bekatresh/ECE-445/notebooks/Eshrit_notebook/New_entries.Md

# Date: January 29

Our group finalised the project idea over the week and we began to work on the project proposal. The main agenda was to come up with a comprehensive block diagram.
We identified three main subsystems: RFID, Breathalyzer, and Data management. We shared multiple ideas to discuss feasibility, and evaluate pros and cons.
We all brought our different ideas, potential pairs of problems an solutions to the table and collaborated effectively to ensure each subsystem complemented the others and functioned well in the overall system. We made sure everyone understood their responsibilities and their duties towards each other. By the end we had a skeleton and a somewhat finished block diagram. Provided below is an image for our vision for the project.



# Date: February 1

We delved further into the problem and tried to identify more issues and ideas on how to tackle those issues. Essentially we thought more about expanding on the implementation of our subsystems and laid out an initial gameplan including the parts we would need and how the product we are delivering would actually be used in practice. We discussed the project idea on a more user friendly level. The project would include RFID-enabled wristbands/cards, a breathalyzer, a Raspberry Pi, and a microcontroller to measure the blood alcohol content (BAC) levels of users and encourage more responsible drinking.
Essentially TipsyTracker would remind users to get their BAC levels checked so they can be in control of their senses on a real scale analysis. The system would alert the host if a guest's BAC levels are above a certain threshold.
I carried forth discussions about the real time use cases and issues about device liquid safety and anticipating the problems for the device in real time such as what would we have the device do in case of system failure, and what would could cause our project to either malfunction or provide mismanaged data. Privacy is also a concern that we would have to tackle since we would be handling so much data about BAC levels.

# Date: February 3

We finalised the proposal and made small edits to it in accordance with the formatting of previous semesters. I assisted with finishing up the block diagram and making the high level requirements be more suitable to the overall success of our project instead of depending on the subsystem workings. We made plans of getting final inputs from the TA and making a submission for the project proposal a day before the deadline.

# Date: February 6th

I picked up the the RFID component and soldered it so that for our team meeting the following day, we can breadboard all components together and test them to see if they work before we proceed with the manafacturing process. Below is a picture of the component we used.



# Date: February 7

We had made plans to breadboard the ordered components and were able to successfully breadboard the complete system design. This step was imperative to test the functionality of the various subsystems and identify any potential issues that needed to be resolved before proceeding with the manufacturing process. Akash made the decision to take the lead on making the PCB schematics with the incorporated parts.

Additionally, breadboarding the entire system helped the team to verify that all the components were correctly interconnected and that the system was working according to the expected standards. By utilizing the expertise of each team member, any problems encountered during testing were effectively addressed to ensure that the system operated as intended.

# Date: February 20

We decided to work on the design document and laid out a plan on how we would use the proposal as a basis and expand on the requirements and verification of the subsystems. In the course of the discussion, we carefully reviewed the current system design, identified areas that required clarification or more development, and discussed the implementation plan. Moreover, we identified potential issues that could arise during the manufacturing process. This comprehensive review allowed us to identify areas for improvement and confirm that the system design was well-documented and comprehended by all team members. This served as a valuable checkpoint regarding lower level understanding of the project. Akash also went over the updates of the PCB schematic. Sumedh, Akash and I at the end of the meeting came up with a more comprehensive division of labor which would be laid out in the schedule subsection of the design document.

# Date: February 21

Hashed out the final editings of the design document, I planned out the schedule and wrote it in the format that was suitable for submission along the lines with what my teammates and I went over in the previous meeting. Followed the plan of expanding the requirements and verification of the subsystems and finished that while concluding the brainstorming from the previous meeting on what verifications would conduct thorough checks for the workings of our subsystems. Prepared the design document for final submission and decided to submit it a day before the deadline.

# Date: February 27

Conducted a successful design review presentation where my teammates and I went over our design document with the Professors and some TAs. We got valuable feedback about a possible problem where our device could be provided with fake BAC values for a user when the air that they blow into the breathalyzer is not generated with enough pressure so that it comes from the lungs. To tackle this the Professor suggested the addition of a pressure sensor and we decided to go over the feasibility of this addition with the TA.

# Date: March 1

I picked up the the pressure sensor component and soldered it so that for our next team meeting, we can breadboard it and test to see if it works as expected before we proceed with the manafacturing process. Below is a picture of the pressure sensor we would be expermenting with.



# Date: March 6

Went over the setup of the website where users can register their information and how their BAC contents get updated with the latest measurements. Went over the functionality of the user getting a notification to test, testing within intervals setup by us and a  text broadcast in case of a subsystem failure which would indicate that the device is not working currently. This helped us discuss more ideas and features in case of subsystem failures. We also discussed the plan for soldering given the PCB. 

# Date: March 7

Headed over to the ECE lab to try and solder the first PCB since we needed to discuss the feasibility of soldering given some of the components were too small (0402 resistors, the diodes and capacitors). The soldering irons in the general area had tips that were too wide but in the special area with the finer soldering tips and the hot air I was able to solder the smaller components much more easily although it was still difficult. We then discussed problems even if I was able to get the components on. We could foresee some bridging issues due to the PCB having components that were too close and the components not having enough solder. We then moved to a newer PCB design which would incorporate through hole components. Below is are the images of the PCB and the PCB with some components soldered.

PCB_1

PCB_1_sol

# Date: March 14

We held a discussion with our TA and went over the feasibility of including the earlier discussed pressure sensor into our project. This was an idea we came back to as mentioned earlier so that the breath tests actually detect air from the lungs for BAC level checks rather than a user who can essentially cheat the breath test. We also briefly went over the design document and any other issues surrounding tipsy tracker and or how we can improve tipsy tracker. This is actually what brought back up the incorporation of a pressure sensor. The TA was for the inclusion of the pressure sensor and after the meeting Akash, Sumedh and I began our research regarding the pressure sensor that I had soldered earlier and how it would fit in with the other subsystems. 

# Date: March 20

Today we conducted the first of the two events that we planned to help with getting accurate BAC level measurements from the Tipsy Tracker device. We invited ten of our friends and made sure that they understood the purpose of the event. Our main objective was to gather accurate and consistent data while creating a relaxed and enjoyable atmosphere for our guests. To achieve this, we offered various snacks and beverages, games and activities to keep the participants engaged. Throughout the gathering, we emphasized the significance of the data collection process for the success of our project, stressing the role each person played in it.
During the event, our guests consumed alcohol and blew into our Arduino-based sensor and commercial breathalyzer at regular intervals. We carefully documented the readings from both devices, along with any contextual factors that could have influenced the results, such as the type and quantity of alcohol consumed and the duration between drinks. This enabled us to obtain valuable data to refine our device and algorithms and gain insights into the real-world conditions under which our device would be used. Below is the truncated image of our training data.



# Date: March 21

Today was when we revisited the idea of incorporating the pressure sensor in our project. To start our discussion, we conducted an extensive literature review on pressure sensors and their practical applications. This process helped us comprehend the underlying principles and technologies that govern the functioning of these sensors, which in turn, gave us the confidence to tackle potential issues that may arise.
In a meeting, we discussed several ideas, such as placing a cloth in front of the breathalyzer, creating an enclosure to detect differences in pressure, and covering the pressure sensor with paper to observe changes. We debated the pros and cons of each idea and took into account factors such as cost, implementation ease, and potential impact on the overall device performance.
However each method was not feasible to warrant inclusion of a pressure sensor

Reasons of failure:
1) Cloth failure: Provided inconsistent results which made differentiating changes in blowing pressure.
2) Enclosure to differentiate measurement of pressure: Sensor was not sensitive enough
3) Place a paper over the pressure sensor: Paper was not stable enough during a blow into the breathalyzer.

As a result we decided to move forward with the project without the inclusion of a pressure sensor.

# Date: March 22

Today we conducted the second of the two events that we plannedto help with getting accurate BAC level measurements from the Tipsy Tracker device. We would now be assessing the precision and accuracy of our calibrated system by comparing BAC level approximations with the BAC level readings from the commercial breathalyzer.
We again invited ten of our friends and conducted a series of tests during which each participant tested their BAC levels using Tipsy Tracker's breathalyzer and the commercial breathalyzer throughout the course of the event. Using this data we compounded it with the data gathered from the first event and looked for any obvious patterns or some sort of linear relationship between the two sensors and the two events. We then tried to figure out how we can map the arduino values to the model values keeping into account what the True BAC levels observed from the commerical breathalyzer showed. Below is the truncated image of our model data and how dissimilar it is from the true data.



# Date: March 23

Our team held a meeting and I picked up the newer version of the PCB which incorporated more spread out components and converted the surface mount components to through hole components. We also separated the components into different bags taking into account the values of resistors and capacitors to make the task of looking for components easier whilst soldering the PCB. I also printed out the schematic on paper so that while soldering I could cross-check this labeling. Below is an image of the physical board


# Date: March 24

Today we headed to the lab to knock off the soldering off some components. We were able to get the microcontroller soldered using the low temp solder and hot air. Once the microcontroller stabilized we added some more soldered using the fine tip soldering iron on each connection and it was verified by a TA as correct. 



# Date: March 25

We soldered 90% of the board adding the other components to the PCB and the sensors. Some surface mount components and a couple other components remained to be soldered. The USB to UART component used to program the microcontroller was almost impossible to solder. The replacement component could not be incorporated into our schematic. The image below shows a failed soldering attempt at U2.



# Date: March 28

We held a brief team discussion about the feasibility of soldering and just the project in general with our TA Dushyant. During our meeting, we shared valuable tips and tricks, and brainstormed potential solutions to enhance our soldering process. Some of the suggestions included investing in high-quality soldering equipment like a soldering station with temperature control and a hot air rework station for surface-mount components. We also considered attending workshops or classes to further develop our soldering skills.

# Date: April 4

We collectively decided that creating an alternate PCB utilizing the development board would be an important step. This would provide us with a reliable backup plan in case any unexpected issues arise with our primary breathalyzer system, thereby ensuring the overall success and dependability of our project. This decision was made to minimize any risks associated with potential problems in our main breathalyzer system. Below is the image for the layout of the Development board PCB.



# Date: April 8

Today arrived the development board PCB, which was created as a backup solution for our primary breathalyzer system. We will solder the component shortly.



# Date: April 10

We successfully finished soldering the Development board PCB. This was much easier than the other PCB designs as visible in the layout of the PCB above. Given the infeasibility of the USB to UART component in our design, it was looking like we would have to activate our backup option which was this PCB.
After soldering, we conducted rigorous testing to ensure that the PCB was functioning as intended, and we were pleased to find that it was successful. We also began discussing the possibility of creating a 3D enclosure to house the development board PCB. Below is an image of our soldered development board PCB.



# Date: April 15

With our Mock Demo coming up, our team held a meeting to prepare for it. We were advised by our TA to have the mock demo be as similar to the real demo as possible and we took this advice fairly seriously. We prepared a skit according to how it would be best to deliver our product to an audience guiding them through various test cases and enacting real life use cases. By conducting a practice session, we were able to refine our presentation skills, ensuring a smooth delivery of information and identifying any areas that needed improvement prior to the actual demonstration. During the rehearsal, each team member took turns presenting their respective portions of the TipsyTracker project, with a focus on clearly and concisely conveying the system's key attributes and advantages while also addressing potential inquiries or concerns.

# Date: April 18

The Mock demo helped us highlight very severe problems with our system. Our device is dependent on the party host setting up a hotspot connection to the device. This was not possible because the ECEB building has extremely poor cellular reception. This caused delay or the stoppage of the partygoers getting notifications about their BAC levels. The RFID subsystem also stopped working as expected, it was working erratically and then completely stopped working. We re-ordered the RFID sensor and resoldered the system.

# Date: April 22

Akash had briefed us on how to use the microcontroller's LAN to connect the modules to each other. However, we still had to show that the partygoers receiving notifications. Hence our team gathered to create a comprehensive video demonstrating all the notification features of our breathalyzer system. The primary objective was to showcase the complete functionality of our communication system, including sending notifications to users and hosts. This video would be presented during the demo to provide the audience with a clear understanding of how the communication system operates.

To ensure everything worked as intended, we set up the breathalyzer system and connected all the necessary components during the meeting. Each team member played a role in the filming process, from operating the breathalyzer system to recording the notifications on various devices.

We then recorded the functionality of our project highlighting the test cases of getting the notifications, the device being down, BAC levels being too high for the partygoers and other such cases which we felt were crucial to display the usefulness of TipsyTracker. Although, the ECEB had no cellular reception as a team, we were able to get around this problem and of course with advice from the TA verifying our new approach, were able to get back on track.

# Date: April 26

Today we conducted our final demo showcasing the functionality of our project. The demo went off without a hitch, with all subsystems working together in perfect harmony. Each team member confidently presented their component and stuck to the script well, emphasizing the unique features and benefits of the TipsyTracker.

# Date: April 27

We held a team meeting today to prepare for the Mock presentation since we did not have a lot of time between the final demo and the mock presentation. We prepared a presentation and allocated slides according to what team member would speak to what aspects of Tipsy Tracker. We also quickly went over a couple practice runs of what we would say during the presentation and the general timing structure.

# Date: April 29

Today's team meeting had us go over the presentation and present it to each other 2-3 more times. Each run has us revise a slide or better our delivery regarding a slide. The improvement in our presentation delivery has been evident. We also turned attention to the final design document which would serve as the last document regarding our finished project.

# Date: May 1

We successfully completed the final design document and polished our presentation skills. We began by practicing our presentation for our final piece of the project.
