bekatresh/ECE-445/notebooks/akash_notebook/images/3d_pcb.png

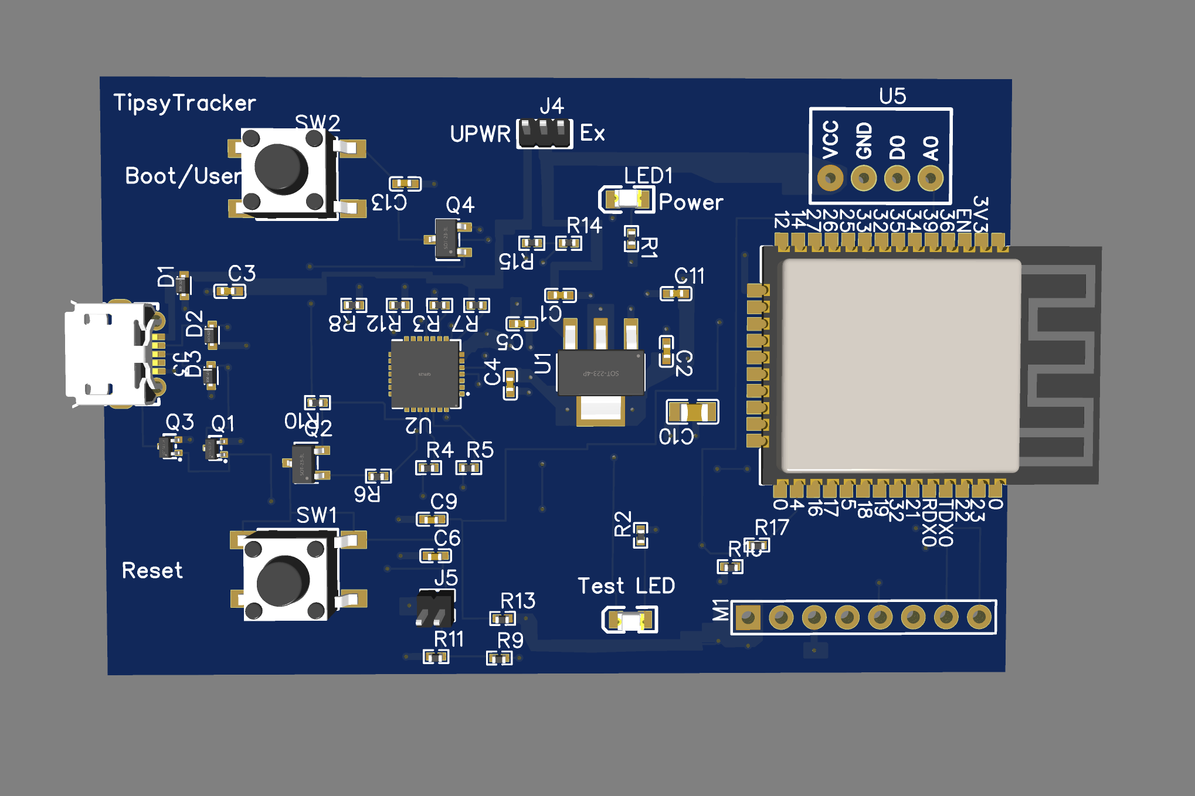
notebooks/akash_notebook/images/3d_pcb.png
