bekatresh/ECE-445/notebooks/Sumedh_notebook/pics/4.png

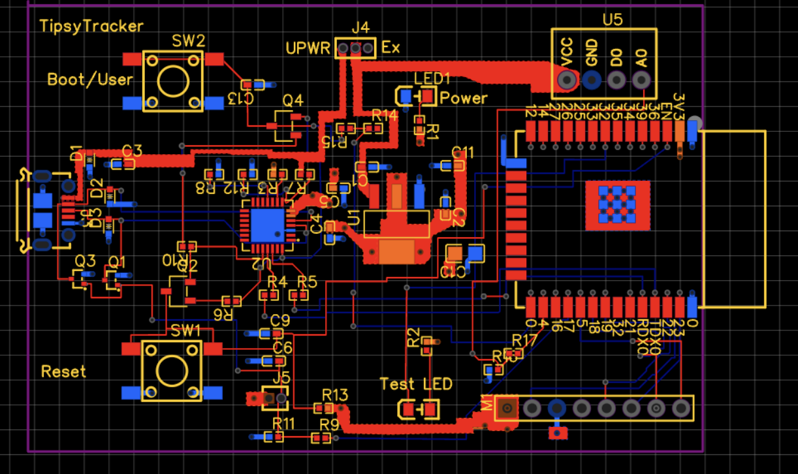
notebooks/Sumedh_notebook/pics/4.png
