bekatresh/ECE-445/notebooks/Sumedh_notebook/pics/9.png

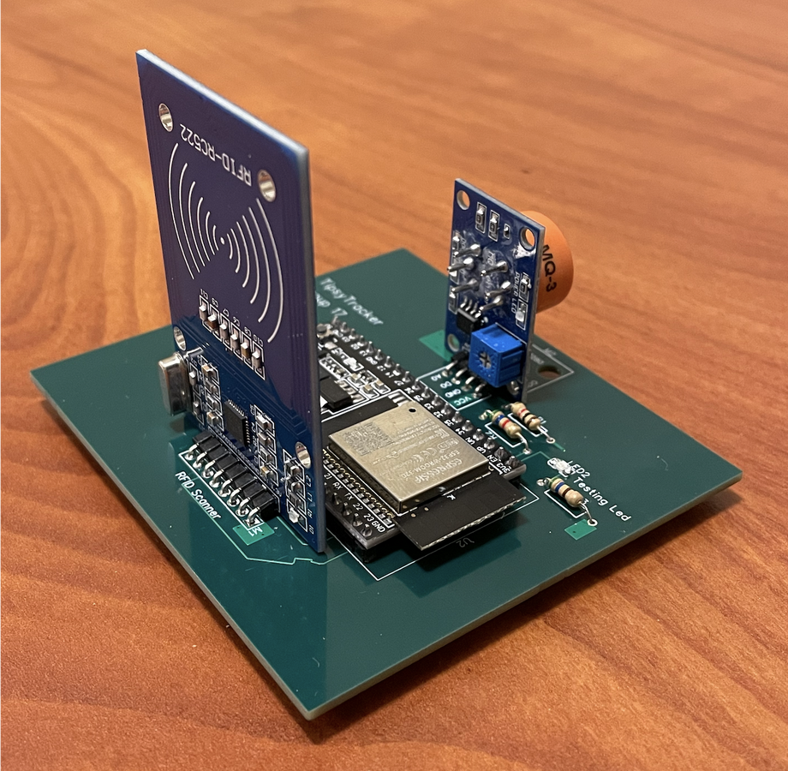
notebooks/Sumedh_notebook/pics/9.png
