bekatresh/ECE-445/notebooks/akash_notebook/images/web_portal_history.png

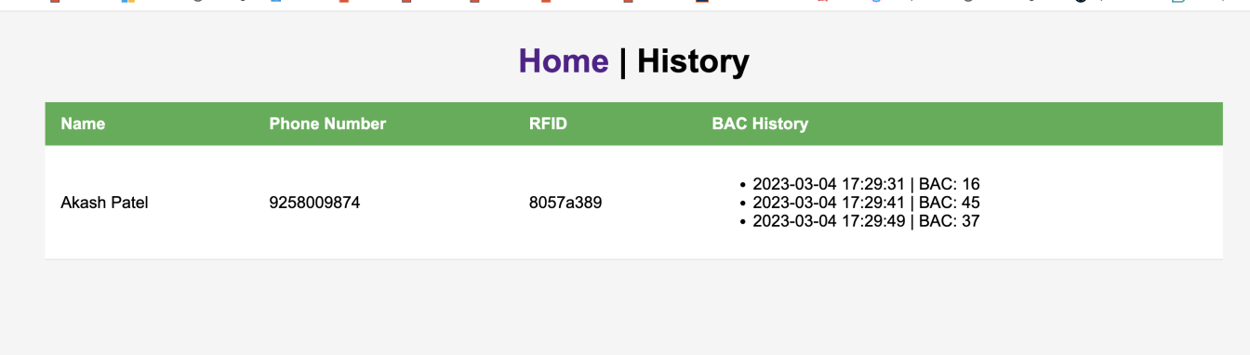
notebooks/akash_notebook/images/web_portal_history.png
