bekatresh/ECE-445/(commit log)

2023-02-06 Create boards
2023-02-07 Create code sample
2023-02-07 Create sample
